mlieschnegg/robu_lab_bhme21/README.md

# ROS2 Laborübungen – 5BHME

Dieses Repository enthält den ROS2-Workspace für die Laborübungen im Schuljahr 2025.  
Die Schüler dokumentieren ihre Arbeitsschritte in Markdown-Dateien und committen Code + Dokumentation in Git.

---

## 📂 Struktur

- `src/` → ROS2-Packages (z. B. `msrobot/`, `rubiksolver/`)  
- `docs/` → Dokumentation pro Einheit (`einheit01.md`, `einheit02.md`, …)  
- `images/` → Screenshots & Fotos, unterteilt nach Einheiten  

---

## 📑 Dokumentation der Einheiten

- [Einheit 01 – CandyBot URDF & Master/Slave](docs/einheit01.md)  
- Einheit 02 – (folgt)  
- Einheit 03 – (folgt)  

---

## ℹ️ Anleitung

Siehe [ANLEITUNG.md](ANLEITUNG.md) für Hinweise zur Dokumentation.
