mlieschnegg/robu_lab_bhme21/src/msrobot/msrobot_description/meshes/cage/stl/cage.STL

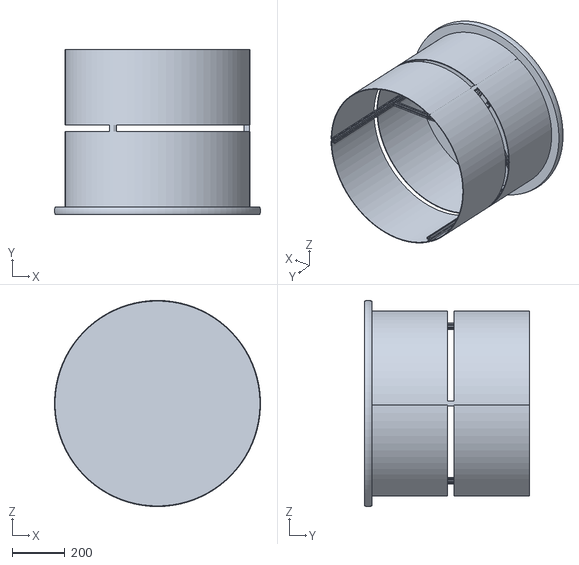
[picture p1: CAD file, 2025-09-09]
src/msrobot/msrobot_description/meshes/cage/stl/cage.STL
784.3 x 628.0 x 784.8
