mlieschnegg/robu_lab_bhme21/src/msrobot/msrobot_description/meshes/follower/step/elbow_to_wrist_extension.step

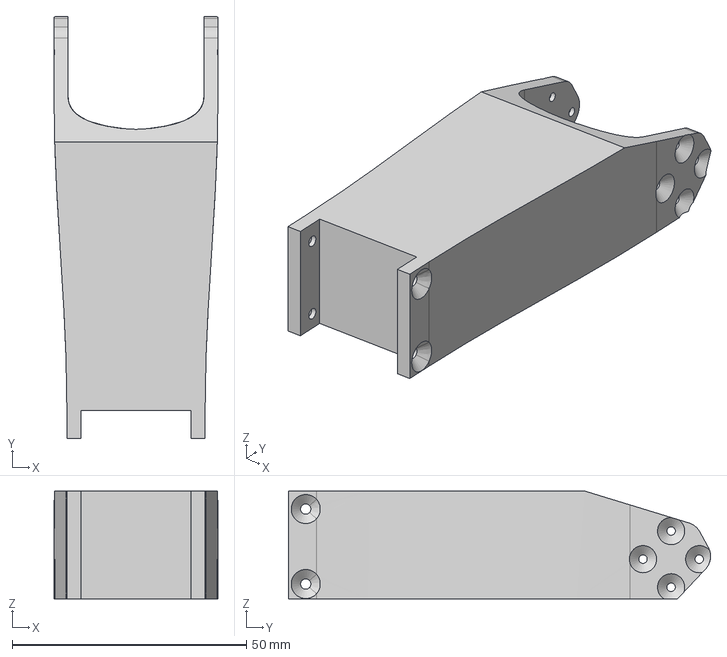
[picture p3: CAD file, 2025-09-09]
src/msrobot/msrobot_description/meshes/follower/step/elbow_to_wrist_extension.step
35.0 x 90.1 x 23.0 mm
