mlieschnegg/robu_lab_bhme21/src/msrobot/msrobot_description/meshes/follower/stl/Alle Teile.3mf

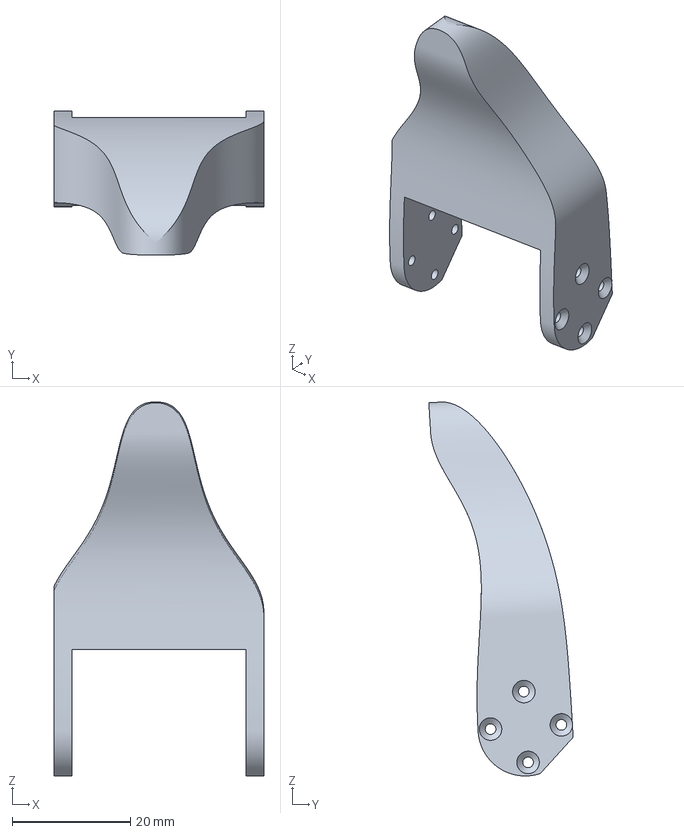
[picture p4: CAD file, 2025-09-09]
src/msrobot/msrobot_description/meshes/follower/stl/Alle Teile.3mf
35.5 x 24.4 x 63.3 mm
