mlieschnegg/robu_lab_bhme21/src/msrobot/msrobot_description/meshes/leader/step/gripper_handle.step

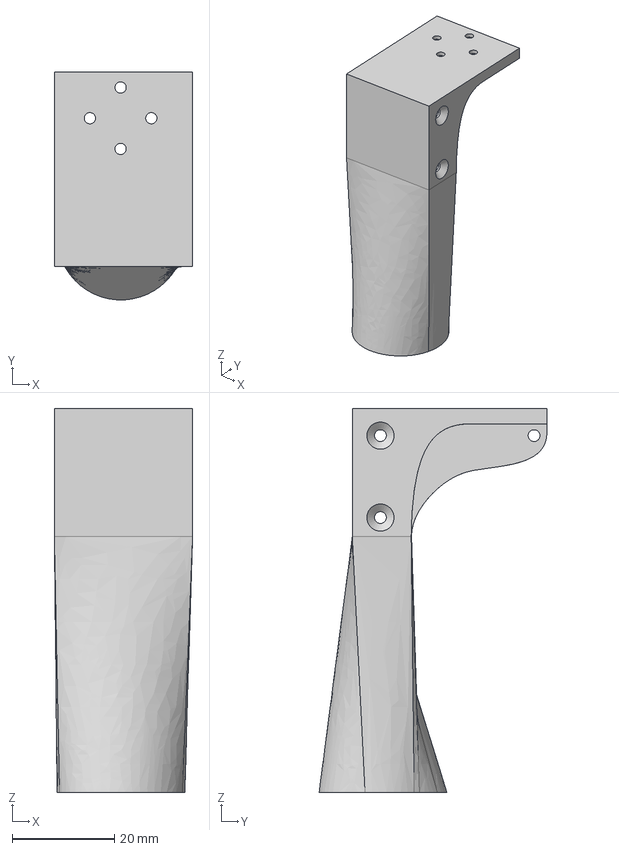
[picture p5: CAD file, 2025-09-09]
src/msrobot/msrobot_description/meshes/leader/step/gripper_handle.step
27.0 x 44.5 x 75.0 mm
