mlieschnegg/robu_lab_bhme21/src/msrobot/msrobot_description/meshes/leader/stl/Alle Teile.3mf

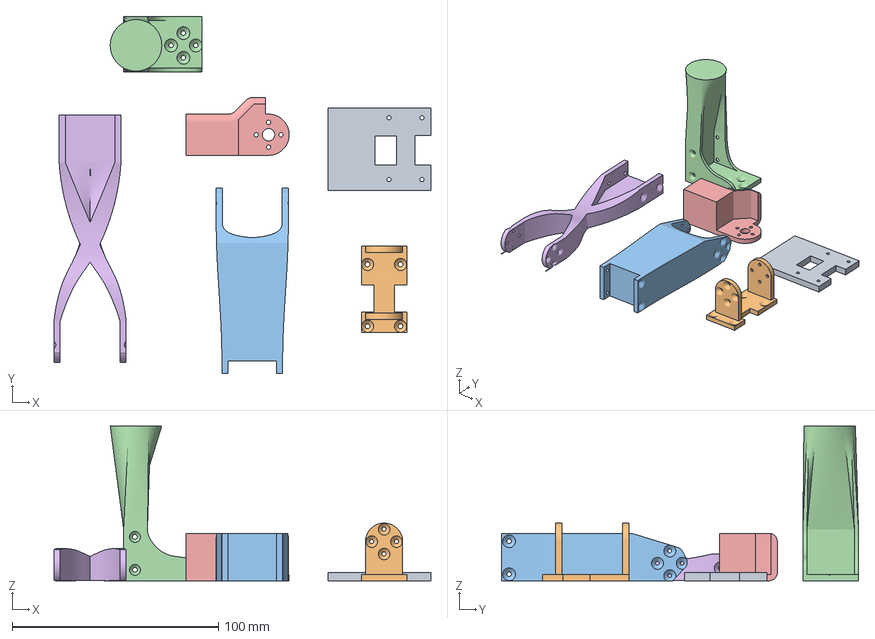
[picture p6: CAD file, 2025-09-09]
src/msrobot/msrobot_description/meshes/leader/stl/Alle Teile.3mf
182.9 x 173.2 x 75.0 mm
base.stl
elbow_to_wrist.stl
elbow_to_wrist_extension.stl
gripper_handle.stl
gripper_trigger.stl
shoulder_to_elbow.stl
