mlieschnegg/robu_lab_bhme21/src/msrobot/msrobot_description/meshes/follower/dynamixel/XL-430_new.stp

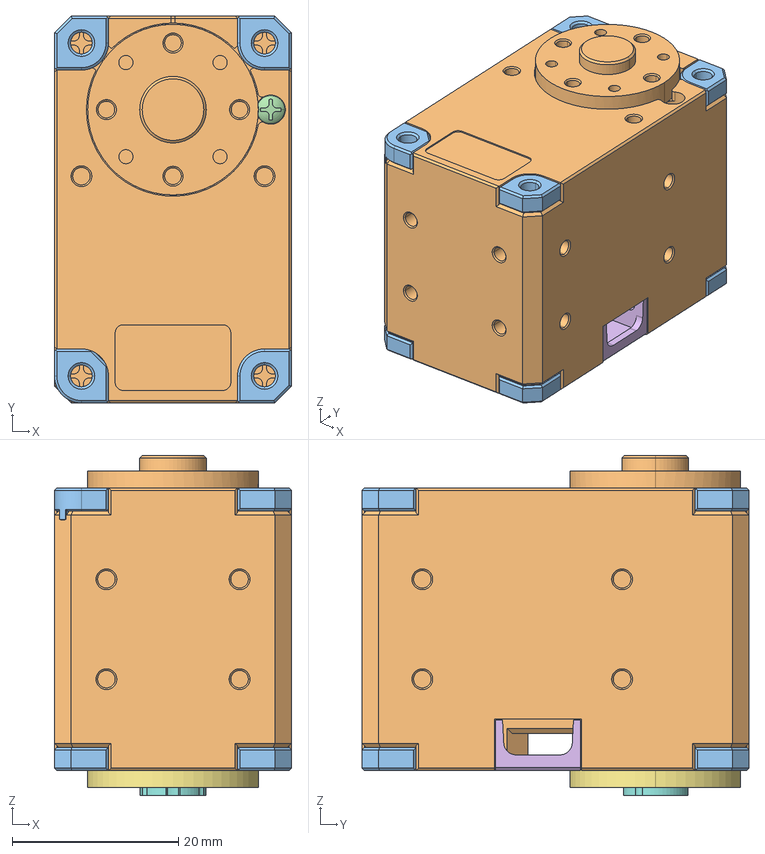
[picture p7: CAD file, 2025-09-09]
src/msrobot/msrobot_description/meshes/follower/dynamixel/XL-430_new.stp
28.5 x 46.5 x 40.9 mm
DC11_A01_DUMMY
DX124_SCREW-COVER
B3B-EH x 2
DC11_A01_CASE_CVR_DUMMY
DC11_A01_IDLER_DUMMY
DC11_A01_IDLER_CAP_DUMMY
DC11_A01_IDLER_SCREW
FHS_M2_5X10 x 8
DC11_A01_SPACER_DUMMY x 8
