mlieschnegg/robu_lab_bhme21/src/msrobot/msrobot_description/meshes/follower/step/elbow_to_wrist.step

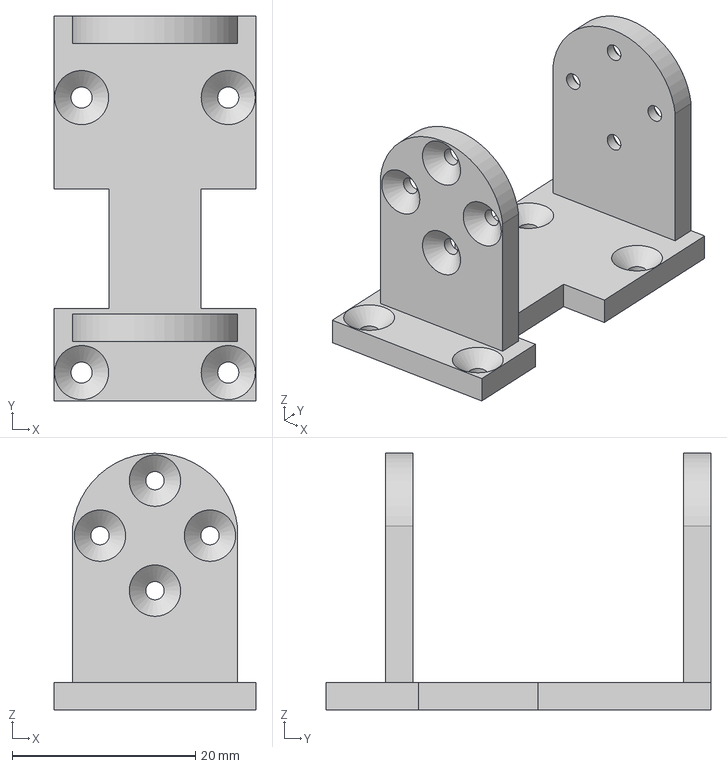
[picture p8: CAD file, 2025-09-09]
src/msrobot/msrobot_description/meshes/follower/step/elbow_to_wrist.step
22.0 x 42.0 x 28.0 mm
