mlieschnegg/robu_lab_bhme21/src/msrobot/msrobot_description/meshes/follower/stl/base.stl

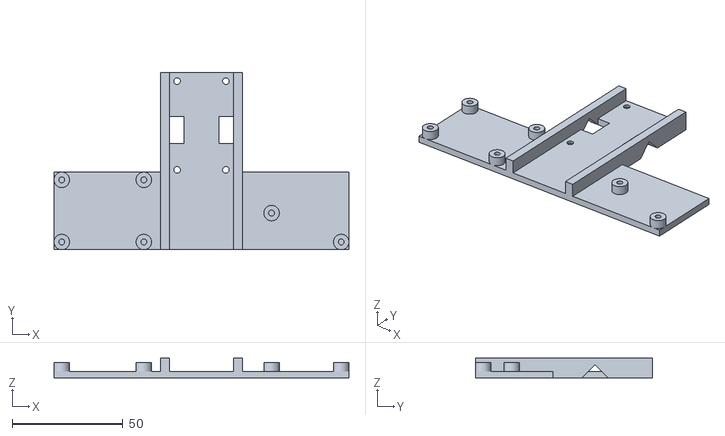
[picture p9: CAD file, 2025-09-09]
src/msrobot/msrobot_description/meshes/follower/stl/base.stl
133.0 x 80.0 x 9.00
