mlieschnegg/robu_lab_bhme21/src/msrobot/msrobot_description/meshes/leader/step/gripper_trigger.step

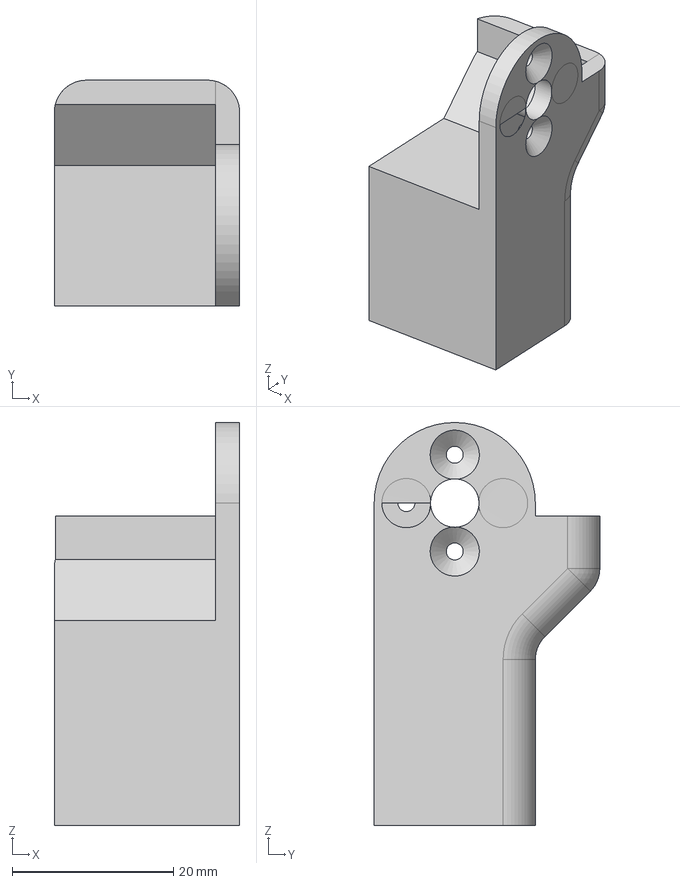
[picture p10: CAD file, 2025-09-09]
src/msrobot/msrobot_description/meshes/leader/step/gripper_trigger.step
23.0 x 28.0 x 50.0 mm
