mlieschnegg/robu_lab_bhme21/src/msrobot/msrobot_description/meshes/follower/step/arm.step

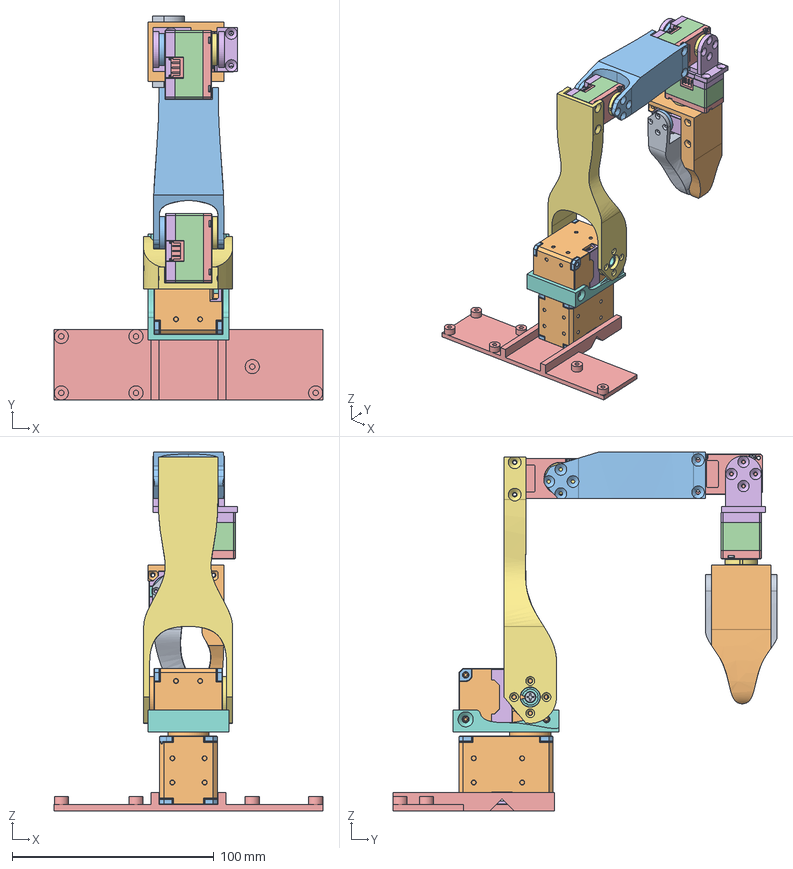
[picture p14: CAD file, 2025-09-09]
src/msrobot/msrobot_description/meshes/follower/step/arm.step
133.0 x 190.2 x 177.6 mm
DC11_A01_DUMMY x 2
DX124_SCREW-COVER x 2
B3B-EH x 4
DC11_A01_CASE_CVR_DUMMY x 2
DC11_A01_IDLER_DUMMY x 2
DC11_A01_IDLER_CAP_DUMMY x 2
DC11_A01_IDLER_SCREW x 2
FHS_M2_5X10 x 16
DC11_A01_SPACER_DUMMY x 16
DC15_A01_CASE_M_DUMMY x 4
DC15_A01_CASE_F_DUMMY x 4
DC15_A01_CASE_B_DUMMY x 4
DC15_A01_HORN_DUMMY x 4
DC15_A01_LED_CAP2_DUMMY x 4
PHS_1_7X20_5_DC10 x 16
BTS2_M2_6X8 x 8
DC15_A01_HORN_IDLE2_DUMMY x 4
DC15_A01_IDLE_CAP_DUMMY x 4
B3B-EH_1 x 8
Base
shoulder_rotation
connector
rotation connector
moving side
static side
connector_1
