mlieschnegg/robu_lab_bhme21/src/msrobot/msrobot_description/meshes/follower/step/gripper_moving_part.step

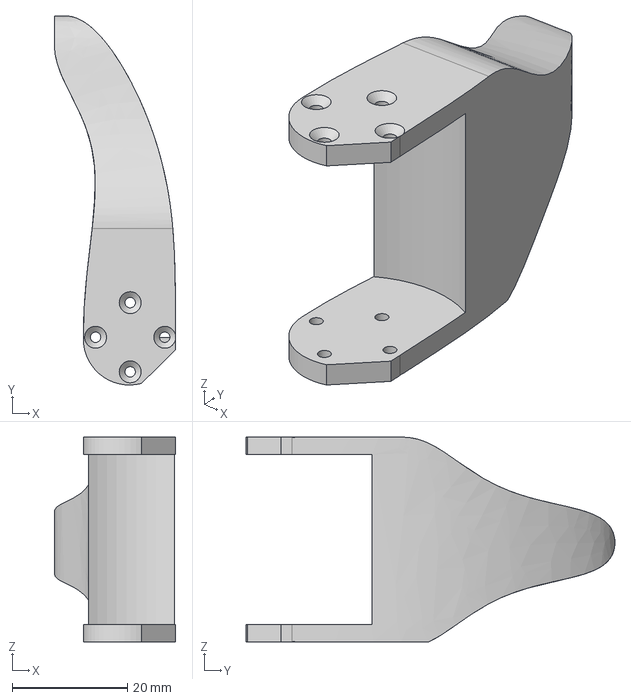
[picture p17: CAD file, 2025-09-09]
src/msrobot/msrobot_description/meshes/follower/step/gripper_moving_part.step
21.0 x 64.0 x 35.5 mm
