mlieschnegg/robu_lab_bhme21/src/msrobot/msrobot_description/meshes/leader/step/base.step

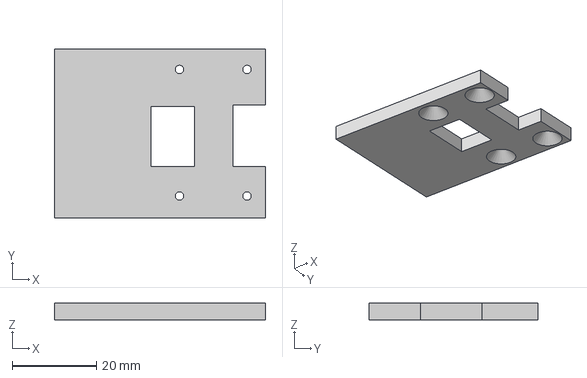
[picture p18: CAD file, 2025-09-09]
src/msrobot/msrobot_description/meshes/leader/step/base.step
50.0 x 40.0 x 4.00 mm
