mlieschnegg/robu_lab_bhme21/(list of files, cad)

Other CAD files:
src/msrobot/msrobot_description/meshes/leader/step/elbow_to_wrist.step
src/msrobot/msrobot_description/meshes/follower/dynamixel/XL-330.stl
src/msrobot/msrobot_description/meshes/follower/dynamixel/XL-430_new.stl
src/msrobot/msrobot_description/meshes/follower/stl/elbow_to_wrist.stl
src/msrobot/msrobot_description/meshes/follower/stl/elbow_to_wrist_extension.stl
src/msrobot/msrobot_description/meshes/follower/stl/gripper_moving_part.stl
src/msrobot/msrobot_description/meshes/follower/stl/gripper_static_part.stl
src/msrobot/msrobot_description/meshes/follower/stl/shoulder_rotation.stl
src/msrobot/msrobot_description/meshes/follower/stl/shoulder_to_elbow.stl
src/msrobot/msrobot_description/meshes/leader/stl/base.stl
src/msrobot/msrobot_description/meshes/leader/stl/elbow_to_wrist.stl
src/msrobot/msrobot_description/meshes/leader/stl/elbow_to_wrist_extension.stl
src/msrobot/msrobot_description/meshes/leader/stl/gripper_handle.stl
src/msrobot/msrobot_description/meshes/leader/stl/gripper_trigger.stl
src/msrobot/msrobot_description/meshes/leader/stl/shoulder_to_elbow.stl
