mlieschnegg/robu_lab_bhme21/images/anleitung/1_Einheit_.png

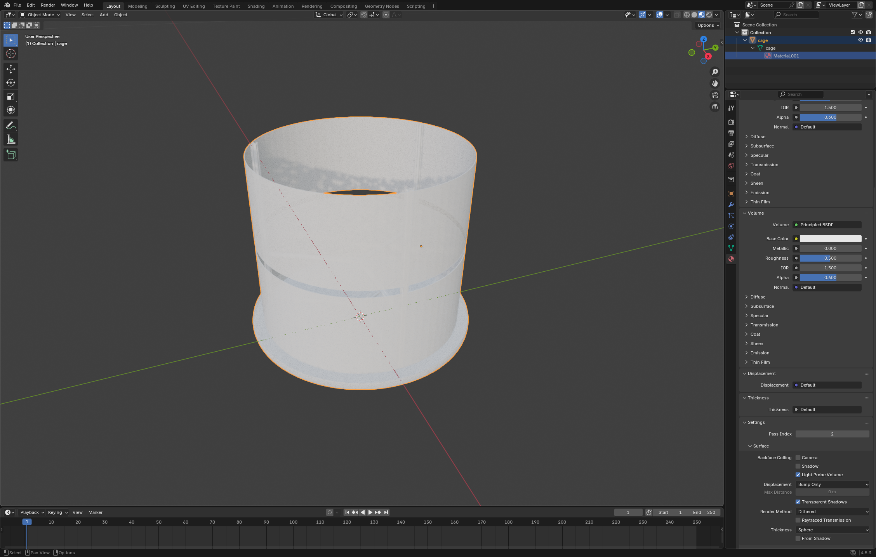
images/anleitung/1_Einheit_.png
