mlieschnegg/robu_lab_bhme21/(commit log)

2025-09-17 Revise Einheit01 documentation for clarity and updates
    Updated documentation for camera issue resolution and adapter modifications.
2025-09-19 - Cage STL Farbe geben und Glas herum transparent machen. - Candy Colada Fila hinzugefügt - Cage zwischen world_link und base_link hinzugefügt
    [msrobot_follower.urdf.xacro]
